Bromide5/models/Umaze_V2改版说明.md

# U 型迷宫 V2 改版说明（2026-10-11）

上一版：`Umaze_110x110x40.*`（2026-10-08，未改动，保留）。本版按你的 6 条要求重做，参数化脚本为唯一源文件。

## 一、改动对照

| 你的要求 | 实现 | 说明 |
|---|---|---|
| 迷宫内部改为 100×100×40 | 内腔 **100 × 100 × 40**（40 = 净深/水深） | 外廓随之变为 **110 × 110 × 45**（壁厚/底厚 5） |
| 两个 U 分支通道宽度改为 28 | 左右支路各 **28** | 中间岛随之变为 **44**（= 100 − 28 − 28） |
| U 形底部与上部分界线处加装卡槽 | 分界线（中岛末端，y = 71）每侧一道 **40.8 × 2.4** 卡槽 | 卡槽从内腔底面一直开到顶面，挡板自上插入 |
| 另外绘制新的配套挡板 | **`Baffle_Door_40`**：40.4 × 2.0 × 39.95 板 + 14×8×12 手柄（带 Ø4 孔），共 2 片 | 打印件；同一道槽也可直接插玻璃片 |
| 支路隔断挡板卡槽要能容纳 40 宽玻璃片并留余裕 | 槽长 **40.8**（40 的玻璃片每侧留 0.4 余裕） | 槽宽 2.4，可容纳 ≤2.2 mm 厚的玻璃片/打印件 |
| 稍微缩小 U 形底部鱼自由活动空间 | 底部连通区 **40 → 34**（鱼活动区 100 × 34） | 中岛由 60 加长到 66 |

## 二、卡槽为什么是偏置的（关键设计取舍）

40 mm 宽的玻璃片插进 28 mm 宽的通道，卡槽必须在两侧壁共咬进 12.8 mm。外壁只有 5 mm 厚——如果对称各咬 6.4 mm，就会把外墙切穿，槽变成通缝，**水会从槽口漏出去**。

因此每道槽做成偏置：

- 外侧壁只咬 **1.5 mm**（外壁还剩 **3.5 mm**，绝不切穿，水密）；
- 其余 **11.3 mm** 埋进 44 mm 厚的中岛，中岛材料充足。

代价：挡板/玻璃片相对通道中心偏向中岛约 4 mm（外观上的不对称），但 28 mm 的通道口被完全封住，隔断功能不受影响。

> 如果你更希望挡板居中：可以 (a) 在槽位置给外壁加一个局部凸台（外廓不变），或 (b) 整体壁厚加到 8.5 mm（外廓变 117×117）。告诉我走哪条，我 5 分钟内改好。

## 三、装配与使用

1. 迷宫开口朝上放置；分界线在**距封闭端 34 mm** 处（中岛末端）。
2. 挡板/玻璃片从上方垂直插入槽内，落到内腔底面（z = 5 mm）为止；打印挡板的手柄会搁在沿口上，天然定位。
3. 经典流程：鱼先放在 U 形底部连通区（100 × 34），两片挡板插上 → 底部即成为"起始区"；实验开始时把两片同时抽出，两条支路同时打开，鱼自由选择。
4. 支路末端保留论文原设计的 **35 × 50 mm 盖玻片缝**（槽长 35.4、宽 1.0，距臂端 20 mm）与 **20 × 28 观察腔**，用于放置刺激鱼。

## 四、关键尺寸表

| 项 | 值 (mm) | 推导 |
|---|---|---|
| 外廓 | 110 × 110 × 45 | 100 + 2×5 |
| 内腔 | 100 × 100 × 40 | 给定 |
| 总高 | 45 | 底 5 + 净深 40 |
| 分支通道宽 | 28 × 2 | 给定 |
| 中岛宽 | 44 | 100 − 2×28 |
| 中岛长 | 66 | 100 − 34 |
| 底部连通区深 | 34 | 40 → 34（"稍微"缩小） |
| 分界线位置 | y = 71 | 110 − 5 − 34 |
| 挡板卡槽 | 40.8 × 2.4 | 1.5（外壁）+ 28（通道）+ 11.3（中岛） |
| 盖玻片卡槽 | 35.4 × 1.0，距臂端 20 | 1.5 + 28 + 5.9；孔径按 35 盖玻片 |
| 打印挡板 | 40.4 × 2.0 × 39.95（+手柄） | 槽长 40.8 留 0.4 配合余量 |
| 水量 | ≈ 284 mL | 通道面积 7096 mm² × 40 |

## 五、文件清单

| 文件 | 内容 |
|---|---|
| `Umaze_110x110x45.step` / `.stl` | 迷宫本体（送 Inventor / 切片打印） |
| `Baffle_Door_40.step` / `.stl` | 配套挡板，**打印 2 片** |
| `Glass_Baffle_40x40x2.step` | 40×40×2 玻璃片参考件（按你实际玻璃尺寸可改） |
| `Umaze_iLogic.vb` | V2 iLogic 规则（Inventor 内原生重建迷宫/挡板） |
| `build_umaze.py` | 参数化源脚本（CadQuery，`uv run --with cadquery python build_umaze.py`） |
| `verify_umaze.py` | 回读验证 + 标注平面图（`uv run --with cadquery --with matplotlib python verify_umaze.py`） |
| `preview_top/iso/asm/spec.png(.svg)` | 俯视 / 等轴测 / 装配 / 标注尺寸平面图 |
| `Umaze_110x110x40.*` | 旧版，未改动 |

## 六、验证结果（从导出的 STEP 重新回读，非脚本自述）

- bbox **110.00 × 110.00 × 45.00**，单一实体，体积 **258 676 mm³**（手算 258 695 减去顶边圆角）
- 材料/空腔探针 **13/13 通过**（含"外壁残厚 3.5 mm"、"槽未穿透外壁"、"中岛加长后 y=65 处仍为实体"）
- 尺寸回测 **13/13 通过**（臂宽 28.00、中岛 44.00、内腔宽 100.00、底部 34.00、槽长 40.80、盖玻片缝 35.40 …）
- 打印件：壁/底 5 mm，槽口最薄残料 3.5 mm，无薄片悬臂

## 七、打印建议

- 迷宫：透明树脂（Clear / 水洗树脂），层高 0.05 mm，槽口朝上摆放，打完用镊子通一遍 40.8×2.4 与 35.4×1.0 槽口（树脂易残留）。
- 挡板：**黑色/不透光树脂**更好（阻断支路间的视觉线索，也避免反光）；若你想让鱼能透过挡板看到对面，就用透明树脂。

## 八、待你确认（我自行判断的三处）

1. **"内部 100×100×40"**：我理解成"内腔净深 40 mm（= 水深）"，所以总高 45 mm。若你的意思是"总高 40（净深 35）"，改 `waterD` / `H` 两个参数即可。
2. **底部连通区 40 → 34 mm**：这是我对"稍微撤小"的取值，可改成任意值（`bandD`）。
3. **玻璃片厚度**：你没说，我按 2.4 mm 槽宽设计（可容纳 ≤2.2 厚）。若你的玻璃是 1 mm 或 3 mm，告诉我槽宽改一下。
