Bromide5/models/preview_asm.png

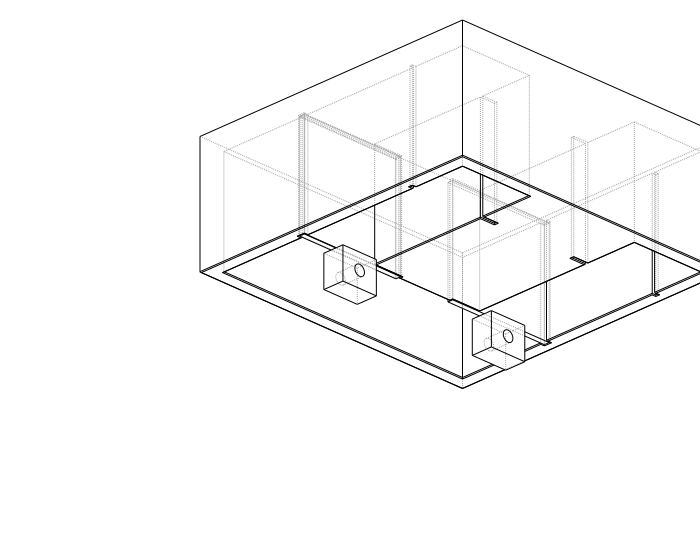
preview_asm.png
