Bromide5/models/preview_iso.png

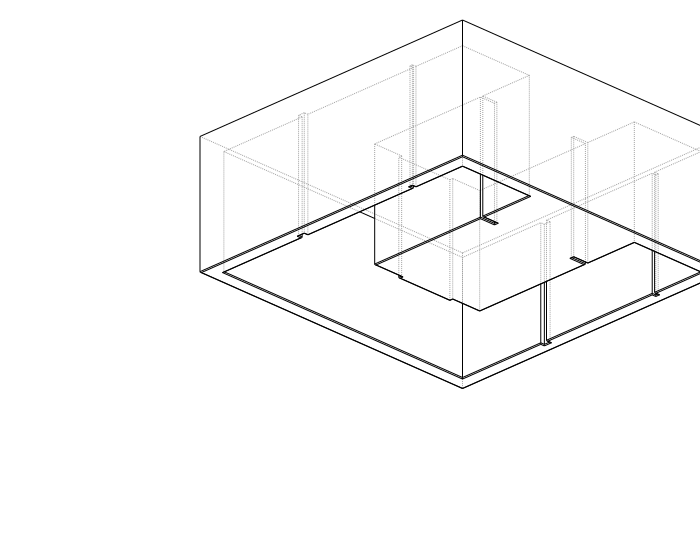
preview_iso.png
