Bromide5/models/preview_spec.png

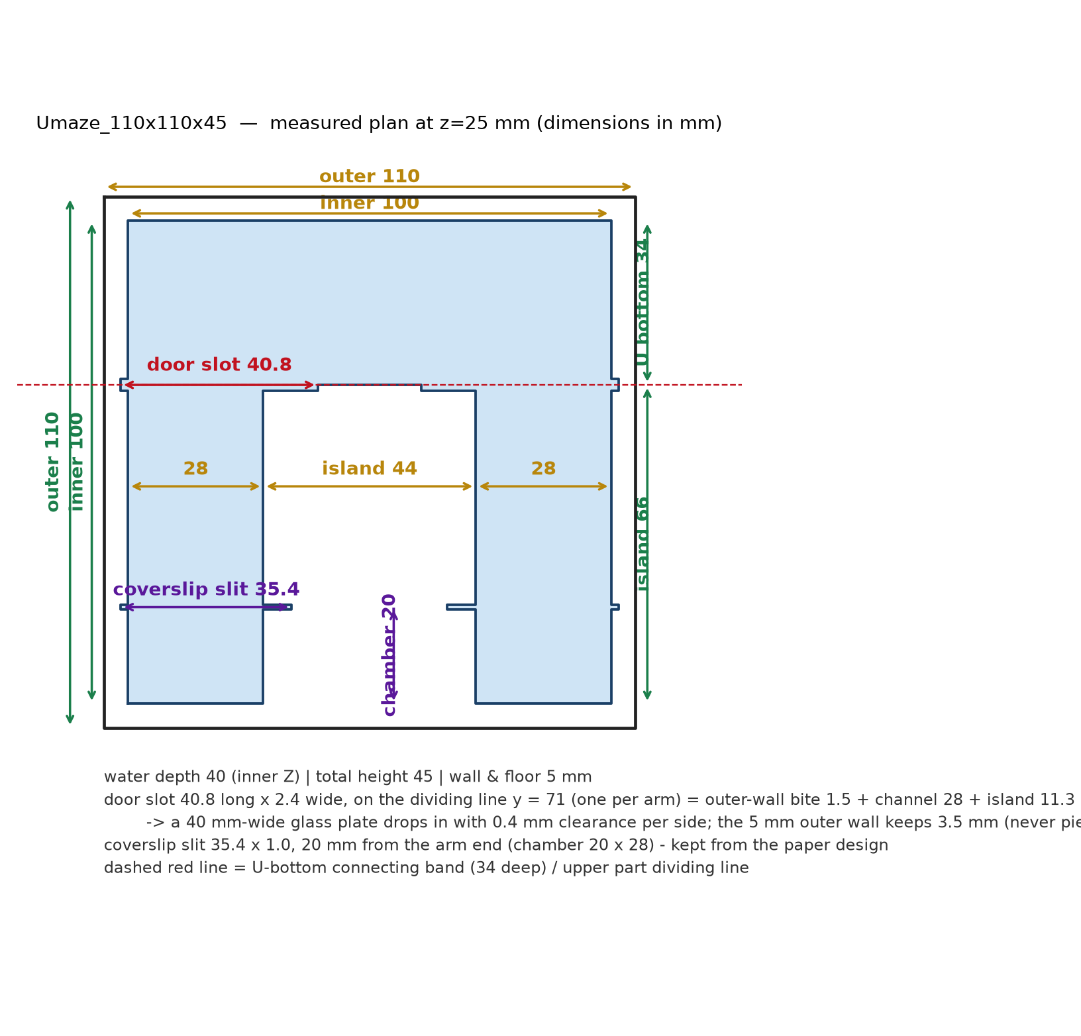
preview_spec.png
