Bromide5/models/preview_top.png

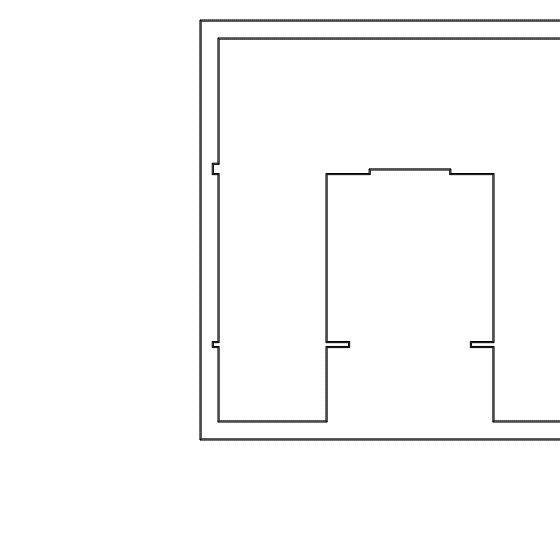
preview_top.png
