Bromide5/models/Umaze_110x110x40.step

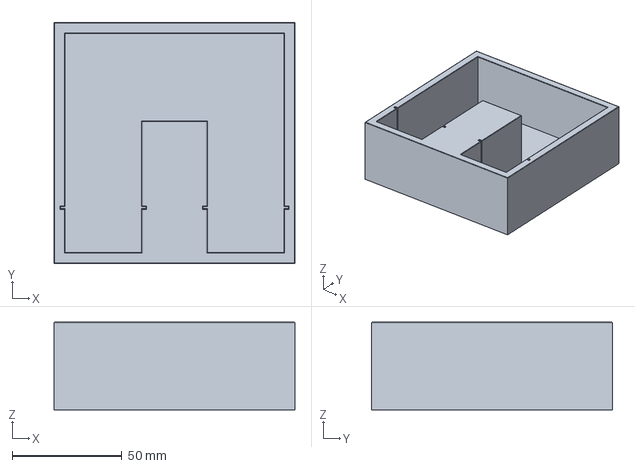
[picture p5: CAD file, 2026-10-11]
Umaze_110x110x40.step
110.0 x 110.0 x 40.0 mm
