Bromide5/models/Umaze_110x110x45/Umaze_110x110x45/Umaze_110x110x45.stp

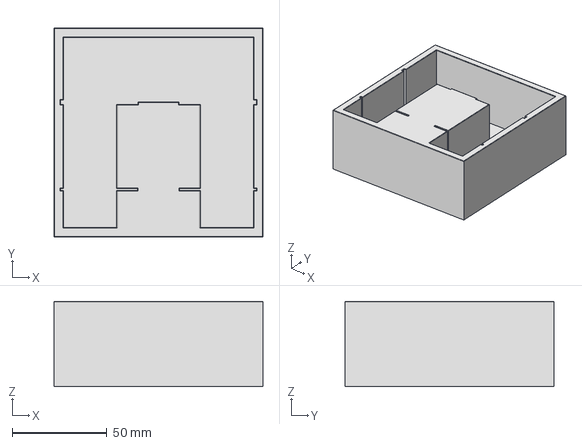
[picture p6: CAD file, 2026-10-12]
Umaze_110x110x45/Umaze_110x110x45/Umaze_110x110x45.stp
110.0 x 110.0 x 45.0 mm
