Bromide5/models/Baffle_Door_40.step

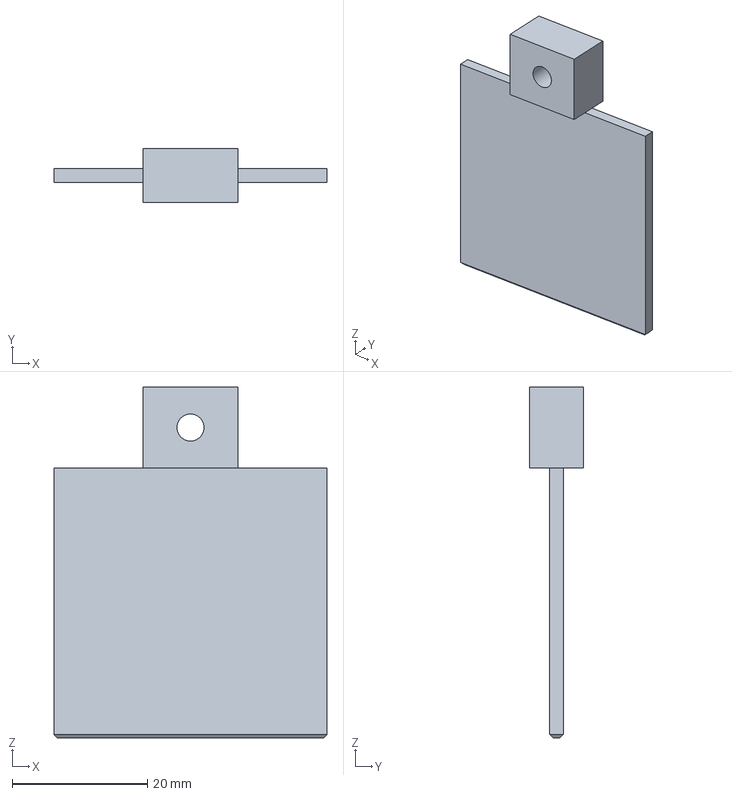
[picture p7: CAD file, 2026-10-11]
Baffle_Door_40.step
40.4 x 8.00 x 52.0 mm
