Bromide5/models/Coverslip_35x50.step

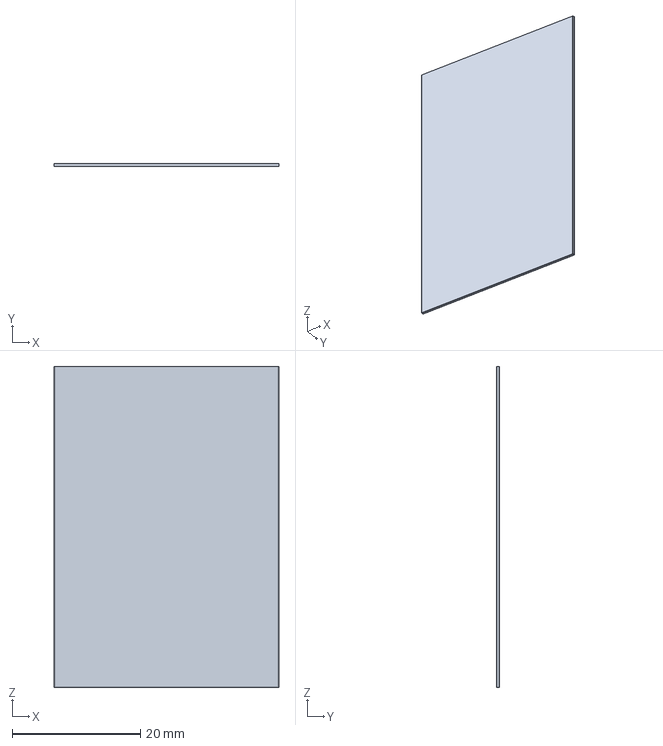
[picture p8: CAD file, 2026-10-11]
Coverslip_35x50.step
35.0 x 0.5 x 50.0 mm
