Bromide5/models/Glass_Baffle_40x40x2.step

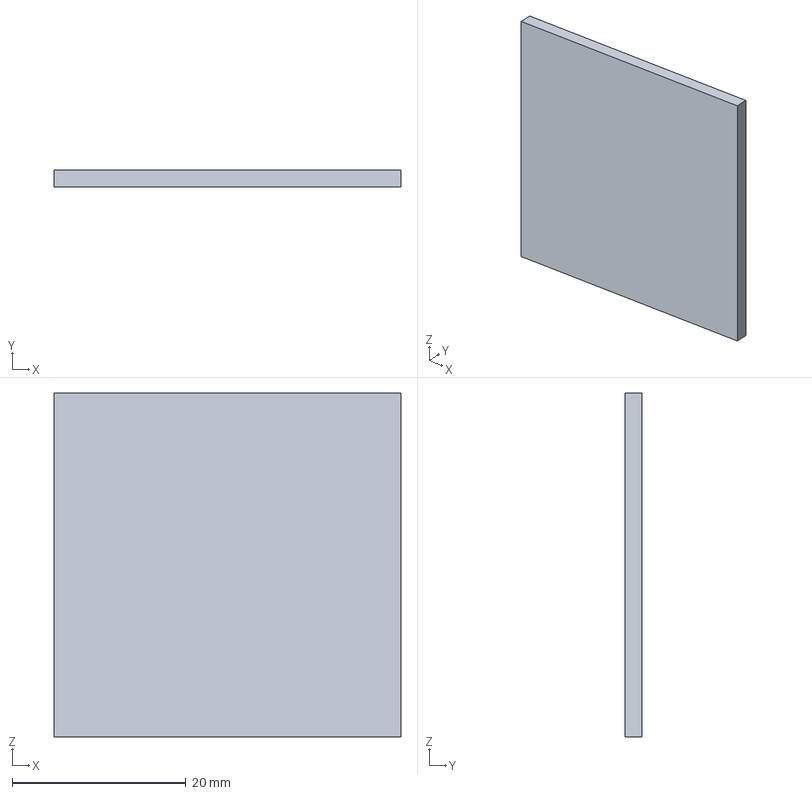
[picture p9: CAD file, 2026-10-11]
Glass_Baffle_40x40x2.step
40.0 x 2.00 x 39.6 mm
