Bromide5/models/(list of files, cad)

Other CAD files:
Umaze_110x110x45.step
Baffle_Door_40.stl
Coverslip_35x50.stl
Umaze_110x110x40.stl
Umaze_110x110x45.stl
Umaze_110x110x45/Umaze_110x110x45/Umaze_110x110x45.ipt
Umaze_110x110x45/Umaze_110x110x45/umaze_wbr.f3d
