Bromide5/models/(commit log)

2026-10-11 U-maze arena v2 for Danionella cerebrum: parametric CAD + matching gate baffle
    Arena (transparent resin): outer 110x110x45 mm, inner cavity 100x100x40,
    U-branch channels 28 mm each, centre island 44 mm, U-bottom connecting band 34 mm.
    - guillotine-gate slot (40.8 x 2.4 mm) on the dividing line of each arm, floor to top,
    so a 40 mm-wide glass plate or the printed baffle drops in with clearance;
    slot bites 1.5 mm into the 5 mm outer wall (3.5 mm remains, watertight) and
    11.3 mm into the island, because a symmetric bite would pierce the outer wall.
    - Baffle_Door_40 (print 2), Glass_Baffle_40x40x2 reference plate, Inventor iLogic rule.
    - Coverslip slits (35.4 x 1.0, 20 mm from the arm end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
    [Baffle_Door_40.step, Baffle_Door_40.stl, Coverslip_35x50.step, Coverslip_35x50.stl, Glass_Baffle_40x40x2.step, Umaze_110x110x40.step, Umaze_110x110x40.stl, Umaze_110x110x45.step]
2026-10-12 修改了Umaze110x110x45的模型
    [Umaze_110x110x45.ipt, Umaze_110x110x45.stp]
2026-10-14 110x110x45第二代迷宫
    [umaze_wbr.f3d]
